graphiccardyo/project-lhy18krg47/analysis/pid_design/summary.txt

플랜트: K∈(0.12, 0.15, 0.21), T=0.328 s, L=16 ms, 공진 3.47 Hz ζ=0.123;  강인성 평가: K×ωr(±10%) 9개 조합

Z-N 한계 이득 (공칭 K=0.15 모델): Ku = 11.49 PWM/°, Tu = 0.299 s (3.35 Hz) — 위상 −180° 가 3.5 Hz 구조 공진에서 일어남
  (K=0.21 이면 Ku = 8.21 — 이득 변동만으로 한계가 29% 줄어듦)

설계                           Kp     Ki     Kd |   공칭Ms   최악Ms    GM     PM     안정 |    tr   OS%    ts    Δu  ess%
P (Ms≤2.0)                 3.70   0.00  0.000 |   1.47   2.00   6.0    nan      예 |  0.42   1.4  0.72    19  64.3
PI (Ti=T, Ms≤1.6)          2.76   8.40  0.000 |   1.32   1.60   8.5   86.6      예 |  1.63   0.3  2.29    34   0.2
PI + 노치 (Ms≤1.6)           7.85  23.93  0.000 |   1.31   1.60   8.7   65.1      예 |  0.40   0.5  0.61    46  -0.0
PID + 노치 (Td=0.05Ti)       7.89  24.05  0.129 |   1.25   1.60   8.6   69.4      예 |  0.42   0.9  0.62    45  -0.0
PID + 노치 (Td=0.10Ti)       7.24  22.07  0.237 |   1.21   1.60   8.6   74.7      예 |  0.50   1.2  0.70    42  -0.1
Z-N P                      5.74   0.00  0.000 |   2.00   4.47   2.2    nan      예 |  0.40   3.3  0.71    29  53.7
Z-N PI                     5.17  20.76  0.000 |   1.82   3.40   3.1   74.6      예 |  0.62   1.9  0.78    37  -0.0
Z-N PID                    6.89  46.13  0.258 |   4.36  28.82  -1.1  -18.9    아니오 |  0.30  15.1  1.13    53  -0.0
Z-N PID + 노치               6.89  46.13  0.258 |   1.37   1.56   8.9   47.0      예 |  0.26  22.7  1.04    59  -0.0

최악Ms·GM[dB]·PM[°]·안정 = 9개 플랜트 조합(K 0.12–0.21 × 공진 ±10%) 중 최악값. tr = 10–90% 상승시간[s], OS·ts(5%)는 최종값 기준, ess = 기준 대비 정상상태 오차[%].
최악Ms > 2 이거나 안정 = 아니오 이면 하드웨어 실험 전에 이득을 낮추세요. Δu = PWM 150 기준 최대 변화.
노치: fn=3.47 Hz, ζz=0.15, ζp=0.70 (출력단 2차 필터). D 항: 자이로 ω 10 Hz LPF, 측정값에 적용.
