graphiccardyo/project-lhy18krg47/data/20261106/analysis/REPORT.md

# 2026-11-06 실험 데이터 — 전달함수 추정 (별도 검증 데이터 없음)

재현: `python analysis/aero_analyze.py data/20261106` → 이 폴더의 `summary.txt`, `static_map.png`, `ringing.png`, `dynamic_fit.png`

| 파일 | 시험 | 조건 |
|---|---|---|
| aero_STAIR_…134531 | 정적 특성 | PWM 50→250 (10씩), 계단 3 s |
| aero_STAIR_…134817 | 정적 특성 | PWM 50→250 (10씩), 계단 1.5 s |
| aero_STEP_…135028 | 스텝 | PWM 180→192→180, pre 12 s / 10 s / 10 s |
| aero_CHIRP_…135133 | 스윕 사인 | PWM 180 ± 12, 0.1→3 Hz 로그, 60 s |

공통 설정: 축 Z−, Madgwick β = 0.301, DLPF 2 (94 Hz), Ts = 10 ms, 샘플 누락 없음.

## 결론

**이 데이터로는 신뢰할 수 있는 동적 전달함수를 얻을 수 없습니다.** 원인은 모델 차수나 추정 방법이 아니라 각도 측정입니다.

1. **가속도계가 프로펠러 진동에 묻혔습니다.** 모터가 돌면 θ<sub>acc</sub>가 ±150° 범위로 흔들립니다(σ 63–84°). β = 0.301로 가속도 비중이 높아 Madgwick θ가 실제 자세에서 벗어나 떠내려갑니다. 그 결과 자이로 적분각과 최대 11–92° 차이가 나고, 정적 특성 그래프가 단조롭지 않습니다.
2. **자이로도 일부 오염되었습니다.** ω에 약 37 Hz, σ 44–123 °/s의 진동이 실려 있습니다. 같은 조건의 정적 특성 두 번이 절대 각도에서 크게 다르게 나왔습니다(PWM 250에서 55° vs 112°). 두 번째 측정에서는 PWM 80일 때 1.5 s 동안 75°가 한쪽으로 쌓였습니다. 진동이 센서 내부 필터 이전 단계에서 ±500 °/s를 넘어 클리핑된 것(비대칭 → 가짜 직류 성분)으로 추정합니다.
3. **스텝·스윕(PWM 180 ± 12)의 신호 대 잡음비가 낮습니다.** 대역별 SNR은 0.5–5이고, 응답 진폭(약 2–4°)이 잡음과 비슷합니다. 2차 모델을 출력오차로 맞추면 적합도는 15% 미만이고, 실험 간 교차검증(STEP↔CHIRP)은 음수입니다.

## 잠정 모델 (검증되지 않음)

그나마 일관된 두 정보로 만든 모델입니다.

- **정적 기울기**(∫ω 기준, PWM 160–200): 0.202, 0.230 °/PWM → **K ≈ 0.22 °/PWM**. 두 번의 측정이 일치합니다. 절대 각도는 서로 달라도 기울기는 드리프트의 영향을 덜 받습니다.
- **자유 진동**(정적 특성 계단 직후 링잉, 감쇠 정현 맞춤): PWM 70→80에서 ωn = 3.65 rad/s, ζ = 0.11(적합 97%). PWM 120→130에서 ωn = 3.46, ζ = 0.30(76%). → **ωn ≈ 3.5 rad/s (0.56 Hz), ζ ≈ 0.1–0.3**.

```
G(s) ≈ K ωn² / (s² + 2ζωn s + ωn²) ≈ 2.7 / (s² + 1.4 s + 12.3)   [deg / PWM]   (K=0.22, ωn=3.5, ζ=0.2)
MATLAB:  G = tf(0.22*3.5^2, [1 2*0.2*3.5 3.5^2]);
```

이 모델도 스텝·스윕 데이터에 대해 적합도가 음수입니다. 따라서 **PID 설계의 출발점으로만** 쓰고, 측정을 고친 뒤 다시 추정해야 합니다. ζ의 불확실성이 특히 큽니다(0.1–0.47).

## 다시 실험하기 전에 고칠 것

**펌웨어에는 반영했습니다 (2026-11-06)**: ±16 g / ±2000 °/s, DLPF 4 기본, β 0.02 기본, 가속도 5 Hz 저역통과 + 게이팅, 포화·게이트 지표 표시. 기존 EEPROM의 축·자이로 보정·영점은 유지되고 β·DLPF만 새 기본값으로 바뀌었습니다. 남은 것은 아래 표의 기계적 조치와 실험 방법입니다.

| 항목 | 이번 | 권장 |
|---|---|---|
| 센서 장착 | — | 고무/폼으로 진동 절연, 프로펠러 균형 확인 |
| DLPF | 2 (94 Hz) | 5 (10 Hz) 또는 4 (21 Hz) — 진자 대역(<3 Hz)은 영향 거의 없음 |
| 센서 범위 | ±4 g / ±500 °/s | ±16 g / ±2000 °/s (센서 내부 클리핑 방지, 펌웨어 수정 필요) |
| Madgwick β | 0.301 | 0.01–0.03 (자이로 위주) |
| 가진 진폭 | ±12 PWM | ±25–40 PWM (SNR↑, 단 비선형 확인) |
| 반복 | 1회 | 같은 시험 2회 이상 (재현성 확인 = 검증 데이터 역할) |

측정을 고친 뒤 확인할 것: 모터를 켠 정지 상태에서 θ<sub>acc</sub>와 Madgwick θ가 몇 도 안에서 일치하는지, 그리고 같은 정적 특성 시험을 두 번 했을 때 결과가 겹치는지.

검증 데이터가 따로 없어도 MATLAB에서 `aero_sysid_all({스텝, 스윕, PRBS…}, 'angle', 'gyro')`로 합동 추정과 실험 간 교차검증을 할 수 있습니다.
