graphiccardyo/project-lhy18krg47/data/20261106_run2/analysis/REPORT.md

# 2026-11-06 2차 실험 데이터 평가 (펌웨어 진동 대책 후)

재현:
```
python analysis/aero_analyze.py data/20261106_run2      # 품질·재현성·정적 특성·교차검증 → summary.txt, *.png
python analysis/aero_freqresp.py data/20261106_run2      # CHIRP 주파수응답 → freqresp.png
```
그림: `raw.png`(원 데이터), `static_map.png`, `dynamic_fit.png`, `freqresp.png`, `model_check.png`(최종 모델 비교)

| 파일 | 시험 | 조건 |
|---|---|---|
| MANUAL_141518 | 수동 | PWM 0→250 수동 증가 (식별에는 사용 안 함) |
| STAIR_141550, STAIR_141657 | 정적 특성 ×2 | PWM 50→250, 10씩, 계단 3 s |
| STEP_141825, STEP_141904 | 스텝 ×2 | PWM 150→162→150, pre 12 s / 10 s / 10 s |
| CHIRP_141943, CHIRP_142059 | 스윕 사인 ×2 | PWM 150 ± 12, 0.1→3 Hz 로그, 60 s |

공통: 축 Z−, β = 0.02, DLPF 4, ±16 g / ±2000 °/s, Ts = 10 ms, 샘플 누락 없음.

## 1. 데이터 품질: 식별에 쓸 수 있음

| 지표 | 1차 실험 (β 0.301, DLPF 2) | 2차 실험 (이번) |
|---|---|---|
| θ<sub>acc</sub> 흔들림 σ | 63–84° | **22–27°** |
| 자이로 진동 σ | 44–123 °/s | **23–36 °/s** |
| Madgwick θ와 ∫ω 차이 (중앙값) | 수십 ° 떠내려감 | **0.8°** (최대 1.3–5°, 한 기록만 17°) |
| 반복 실험 상관 (스텝 / 스윕) | — | **0.945 / 0.874** |
| 정적 특성 반복 차이 | 55° vs 112° (불일치) | **RMS 1.0°, 최대 1.9°** |
| 단일 기록 SNR (반복 쌍으로 계산) | 0.5–5 | **6.4 (스텝), 7.4 (스윕)** |

진동이 여전히 있지만(θ<sub>acc</sub> ±25°), 게이팅과 작은 β 덕분에 Madgwick θ가 오염되지 않았습니다. 그래서 이번에는 **기록된 θ를 그대로** 분석에 썼습니다. 같은 시험을 두 번씩 한 덕분에, 별도 검증 데이터 없이도 잡음 수준과 재현성을 직접 확인할 수 있습니다.

**SNR이 6–7이면 어떤 모델이든 단일 기록 적합도의 상한이 약 63–66%입니다.** 아래 적합도는 이 상한과 비교해서 읽어야 합니다.

## 2. 정적 특성 (시험 1)

| PWM | 50 | 100 | 130 | 150 | 170 | 200 | 250 |
|---|---|---|---|---|---|---|---|
| θss (1회) | 4.9 | 11.4 | 17.1 | 21.9 | 24.6 | 29.3 | 39.7 |
| θss (2회) | 6.0 | 12.5 | 17.4 | 21.6 | 26.0 | 31.2 | 40.3 |

- 거의 직선에 가깝게 단조 증가합니다(PWM 50→250에서 5°→40°). 이번 범위에서는 뚜렷한 사각지대가 보이지 않습니다.
- **운전점 PWM 150 부근 국소 이득: 0.19–0.21 °/PWM** (PWM 130–170 회귀).
- 모터를 켜기 전 시작 각도가 기록마다 **+2.4~+5.0°**입니다. 펌웨어를 바꾼 뒤 영점을 다시 잡지 않은 것과, 피벗 마찰로 정지 위치가 매번 조금 달라지는 것이 겹친 것으로 보입니다. 절대 각도에는 수 도의 오프셋이 있고, 기울기(이득)에는 영향이 거의 없습니다.

## 3. 동적 응답 (시험 2)

- **스텝**: +12 PWM에 약 1 s 안에 **오버슈트 없이** Δθ ≈ 2.1–2.6°로 올라갑니다(과감쇠). 정상상태 이득은 0.17–0.21 °/PWM입니다.
- **주파수응답**(스윕 사인 2회, 기록 간 차이 대부분 3–15%):

| f [Hz] | 0.10 | 0.20 | 0.38 | 0.60 | 0.94 | 1.47 | 2.29 | 2.86 |
|---|---|---|---|---|---|---|---|---|
| \|G\| [°/PWM] | 0.165 | 0.145 | 0.119 | 0.101 | 0.076 | 0.060 | 0.065 | 0.084 |
| 위상 [°] | −23 | −32 | −38 | −54 | −69 | −90 | −111 | −142 |

  0.1–1.5 Hz에서는 1차 지연과 비슷한 모양이고, **진자형 공진 봉우리는 없습니다**(이 운전점에서는 진자가 강하게 감쇠됨). 2 Hz 위에서는 이득이 다시 오르고 위상이 빨리 떨어집니다. **약 3 Hz 이상에 다른 모드**(막대·구조 진동 등)가 있을 수 있습니다.
- 정적 특성 계단 직후의 "링잉" 맞춤(ζ≈0.4–0.55, ωn≈2.2–2.7)은 스텝·주파수응답과 맞지 않습니다(주파수응답 오차 85–107%). 계단 직후의 진동 잡음을 감쇠 정현으로 잘못 맞춘 것이므로 쓰지 않습니다.

## 4. 전달함수 추정 (시험 3, 별도 검증 데이터 없이)

스텝 2개와 스윕 2개 모두를 대상으로, **기록 하나를 빼고 추정한 뒤 뺀 기록에 비교하는 교차검증**을 했습니다.

| 모델 구조 | 교차검증 적합도 (CHIRP₁, CHIRP₂, STEP₁, STEP₂) | 평균 |
|---|---|---|
| 1차 + 지연 | 44, 43, 65, 32 % | **46.1 %** |
| 2차 (실극점 2개) + 지연 | 43, 43, 66, 32 % | 46.1 % (두 번째 극점이 사라져 1차와 같음) |
| 2차 (복소극점 허용) + 지연 | 43, 43, 66, 32 % | 46.1 % (ζ→4, 과감쇠로 수렴) |
| 영점 + 극점 2개 + 지연 | 42, 43, 66, 35 % | 46.6 % (느린 성분 τ≈6 s, 개선 미미) |

차수를 올려도 교차검증이 좋아지지 않으므로 **1차 + 지연**을 채택합니다. 느린 성분(τ≈6 s)은 두 번의 스텝에서 크리프 방향이 반대로 나왔습니다(θ: 0.00° / +0.29°, ∫ω: −0.75° / +0.53°). 따라서 물리적인 응답이 아니라 **±0.5–1°의 저주파 드리프트**로 판단합니다. 잡음 상한(63–66%)과 실제 적합도(46%) 사이의 차이는 대부분 이 드리프트 때문입니다(STEP₂는 하강 후 +0.8°에 머묾).

### 추정 모델 (운전점 PWM ≈ 150, θ ≈ 22°)

```
G(s) = Δθ(s)/ΔPWM(s) = 0.174 · e^(−0.025 s) / (0.341 s + 1)     [deg / PWM]
     = 0.510 · e^(−0.025 s) / (s + 2.93)
MATLAB:  G = tf(0.174, [0.341 1], 'InputDelay', 0.025);
```

| 파라미터 | 값 | 불확실성 / 근거 |
|---|---|---|
| 정상상태 이득 K | 0.174 °/PWM | **0.17–0.21** (스윕 저주파 0.16, 스텝 0.17–0.21, 정적 기울기 0.19–0.21) |
| 시정수 T | 0.34 s (극점 −2.9 rad/s, 0.47 Hz) | 교차검증 모델 간 0.34–0.35 s |
| 지연 L | 25 ms | 20–50 ms |
| 유효 대역 | 0.1–1.5 Hz | 2 Hz 이상 미모델 동특성 가능 |

## 5. 평가 요약

- **사용 가능**: 진동 대책 후 데이터는 재현성이 좋고(상관 0.87–0.95), 정적 특성·스텝·주파수응답이 서로 일관됩니다(이득 0.17–0.21 °/PWM).
- **모델 신뢰도는 보통**: 교차검증 적합도 46%(잡음 상한 약 65%). PID 설계에는 충분하지만, 이득을 ±10–15% 불확실한 것으로 보고 강인하게 설계하세요(예: K = 0.17과 0.21 둘 다로 폐루프 검토).
- **이 운전점(PWM 150)에서만 유효한 소신호 모델**입니다. 정적 특성 기울기가 PWM 160–200에서는 0.15–0.18로 조금 작아지므로, 다른 각도에서 제어하려면 그 운전점에서 다시 식별하세요.

## 6. 다음 실험에서 개선할 것

1. **영점 다시 잡기**: 시작 각도가 +2.4~5°입니다. 실험 직전에 "정지 보정 + 영점"을 하세요.
2. **가진 진폭 키우기**: ±12 → ±25 PWM으로 키우면 SNR이 약 4배가 됩니다(선형 범위는 정적 특성상 PWM 125–175 정도에서 무난함).
3. **드리프트 줄이기**: 시험 시간을 줄이거나(스윕 30–40 s) 반복 횟수를 늘려 평균하세요. 정지 상태 θ가 몇 분 동안 얼마나 떠내려가는지도 한 번 기록해 두면 좋습니다.
4. **2 Hz 이상 확인**: 폐루프 대역을 1 Hz 넘게 잡을 계획이면 0.5–5 Hz 스윕을 따로 해서 3 Hz 부근 모드를 확인하세요.
5. 센서 진동 절연은 여전히 권장합니다(θ<sub>acc</sub> ±25°, 자이로 진동 약 46 Hz).
