graphiccardyo/project-lhy18krg47/data/20261106_run3/analysis/REPORT.md

# 2026-11-06 최근 두 run 평가 (고주파 확인 · 진폭 확대)

| run | 파일 | 조건 | 목적 |
|---|---|---|---|
| **A** | CHIRP_143402, CHIRP_143517 | PWM 150 ± 12, **0.1→10 Hz** 로그, 60 s | 2 Hz 이상 동특성 확인 |
| **B** | CHIRP_143817, CHIRP_143940 | PWM 150 ± **25**, 0.1→7 Hz 로그, 60 s | 진폭 확대(SNR↑) |

공통: 축 Z−, β 0.02, DLPF 4, ±16 g / ±2000 °/s, 샘플 누락 없음, 각 조건 2회 반복.

재현:
```
python analysis/aero_analyze.py data/20261106_run3
python analysis/aero_model_fit.py --est data/20261106_run3/aero_CHIRP_20261106_143817.csv data/20261106_run3/aero_CHIRP_20261106_143940.csv --val "data/20261106_run3/aero_CHIRP_*.csv" "data/20261106_run2/aero_CHIRP_*.csv" "data/20261106_run2/aero_STEP_*.csv"
```
그림: `raw.png`, `model_fit.png`(주파수응답 + 모든 기록 시간영역 비교)

## 1. 품질

| 지표 | run2 (±12, 0.1–3 Hz) | **run A** (±12, 0.1–10 Hz) | **run B** (±25, 0.1–7 Hz) |
|---|---|---|---|
| θ<sub>acc</sub> σ / 자이로 진동 σ | 25–27° / 35 °/s | 20–22° / 27–29 °/s | 17–19° / 25–27 °/s |
| Madgwick θ vs ∫ω (최대 차) | 2.5–5° | 1.8° | 1.5–5.9° |
| 반복 쌍 상관 | 0.874 | 0.808 | **0.976** |
| 단일 기록 SNR | 7.4 | 4.6 | **25** |
| 잡음 한계 적합도 | ≈66% | ≈58% | **≈80%** |

- **run B가 지금까지 데이터 중 가장 좋습니다.** 진폭을 두 배로 하자 SNR이 3–4배가 됐습니다.
- run A의 SNR이 낮은 것은 정상입니다. 같은 60 s를 10 Hz까지 나눠 쓰다 보니 응답이 거의 없는 고주파(>5 Hz, 응답 ≈0.05°)에 시간을 많이 썼기 때문입니다. 6 Hz 이상의 값은 잡음 수준이라 쓰지 않습니다.
- **오프셋 점프**: CHIRP_143402는 가진이 시작되자 진동 중심이 약 +1.5° 올라가 유지됐습니다. CHIRP_143517은 공진 통과(약 60 s) 직후 약 −1° 내려갔습니다. 진폭이 커지는 순간 피벗 정지마찰이 풀리면서 정지 위치가 바뀌는 것으로 보입니다. 동특성 분석에서는 가진 구간 평균을 빼서 처리했습니다(이 처리 전에는 143402의 적합도가 −94%로 나왔음).

## 2. 새로 확인한 것: 3.5 Hz 기계 공진

주파수응답(두 run 모두, 반복 차이 대부분 2–15%):

| f [Hz] | 0.3 | 0.9 | 1.6 | 2.35 | 2.83 | **3.41** | 4.11 | 4.95 | 5.96 |
|---|---|---|---|---|---|---|---|---|---|
| \|G\| run A | 0.116 | 0.068 | 0.048 | 0.047 | 0.058 | **0.074** | 0.038 | 0.013 | 0.006 |
| \|G\| run B | 0.113 | 0.068 | 0.048 | 0.046 | 0.056 | **0.066** | 0.033 | 0.012 | 0.005 |
| 위상 run B | −32° | −69° | −91° | −107° | −127° | **−187°** | −253° | −277° | −287° |

- **약 3.47 Hz에서 이득이 다시 올라가고(1차 모델 대비 약 3배), 위상이 180° 급격히 떨어집니다.** 약하게 감쇠된(ζ≈0.12) 2차 모드입니다. 진자 자체의 흔들림(1 Hz 미만)이 아니라 막대·모터 마운트의 굽힘 같은 구조 모드로 보입니다.
- 지난 보고서에서 "2 Hz 이상에서 이득이 오름 — 3 Hz 부근 모드 가능"이라고 했던 부분이 이번에 확인되었습니다.
- **선형성**: ±12와 ±25의 이득이 0.3–6 Hz에서 5% 안에서 일치합니다. 진폭을 두 배로 해도 응답 모양이 같으므로 운전점 주변의 선형 모델이 타당합니다.

## 3. 전달함수

run B(±25) 주파수응답에 맞추고, 나머지 모든 기록에 시뮬레이션해 검증했습니다(별도 검증 데이터 없이 실험 간 교차검증).

```
G(s) = K · e^(−0.016 s) / (0.328 s + 1) · 21.8² / (s² + 5.37 s + 21.8²)      [deg/PWM]
       공진 fr = 3.47 Hz (ωr = 21.8 rad/s), ζr = 0.12,  시정수 T = 0.33 s,  지연 16 ms (DLPF 21 Hz 지연 약 8 ms 포함)
MATLAB:  G = tf(K*21.8^2, conv([0.328 1], [1 5.37 21.8^2]), 'InputDelay', 0.016);
```

| 검증 기록 | 형태와 K 모두 run B 값 (K=0.131) | 형태 고정, K만 기록별로 맞춤 | 잡음 한계 |
|---|---|---|---|
| run B CHIRP ×2 (추정에 사용) | 79%, 78% | 81%, 80% (K 0.144 / 0.121) | ≈80% |
| run A CHIRP ×2 | 65%, 55% | 65%, 55% (K 0.127 / 0.134) | ≈58% |
| run2 CHIRP ×2 (15분 전) | 56%, 64% | 59%, 68% (K 0.155 / 0.159) | ≈66% |
| run2 STEP ×2 (20분 전) | 46%, 17% | 77%, 36% (K 0.205 / 0.188) | ≈63% |

- **형태(T, 지연, 공진)는 모든 실험에서 일관됩니다.** K만 맞추면 모든 기록이 각자의 잡음 한계 근처까지 맞습니다. 이 형태를 확정 모델로 봐도 됩니다.
- 주파수응답 오차 9%, 0.12–7 Hz에서 크기·위상 모두 일치(`model_fit.png` 위쪽).
- 0.12 Hz 미만에서는 Madgwick θ와 자이로 적분각의 위상이 다르게 나옵니다(−21° vs −1°). Madgwick의 느린 가속도 보정이나 드리프트에 의한 측정 쪽 효과로 보고 모델에 넣지 않았습니다.

## 4. 문제: 이득 K가 시간에 따라 줄어듦

| 시각 | 기록 | K [°/PWM] | PWM 150 정착 각도 |
|---|---|---|---|
| 14:16–14:18 | run2 STAIR | (정적 기울기 0.19–0.21) | 21.6–21.9° |
| 14:18–14:19 | run2 STEP | 0.19–0.21 | 22.3–23.4° |
| 14:19–14:22 | run2 CHIRP | 0.155–0.159 | 23.5–23.9° |
| 14:34–14:35 | run A | 0.127–0.134 | 20.0–20.9° |
| 14:38–14:39 | run B | 0.121–0.144 | 19.0–19.1° |

- 20분 사이에 같은 PWM 150에서 **정착 각도가 약 3°, 이득이 약 20% 줄었습니다.** 추력이 약해졌다는 뜻입니다. **모터 전원 전압 강하**(배터리 소모, 전원장치 전류 제한)나 **모터 발열**을 의심합니다. 입력을 PWM으로 쓰므로 전원 전압이 바뀌면 플랜트 이득이 그대로 바뀝니다.
- 같은 시각대에서도 스텝(0.19–0.21)이 스윕(0.155)보다 큽니다. 한 방향으로 올리는 입력(스텝·계단)과 양방향으로 흔드는 입력(스윕)의 차이로 보이며, 피벗 마찰 같은 작은 비선형이 원인일 수 있습니다.

## 5. PID 설계에 주는 의미

- **K 범위 0.12–0.21 °/PWM** (공칭 약 0.15). 안정성은 큰 쪽(0.21), 성능은 작은 쪽(0.12)으로 검토하세요.
- **위상 −180° 교차 3.38 Hz, 그때 |G| ≈ 0.076 °/PWM** (K=0.131 기준). 순수 P 제어라면 이득 한계가 약 13 PWM/°이고, K=0.21이면 약 8 PWM/°입니다.
- 3.5 Hz 공진 때문에 **폐루프 교차주파수는 약 1 Hz 이하**로 잡으세요. D 항은 공진을 증폭하므로 미분 필터(예: 10–15 Hz 1차)를 쓰고, 필요하면 3.5 Hz 노치 필터를 고려하세요.
- Z-N 방법(목표 6): 이 플랜트는 순수 P로 진동 한계에 도달하는 주파수가 약 3.4 Hz, 즉 구조 공진입니다. Ku/Tu가 진자 동특성이 아닌 공진으로 정해지므로, Z-N 결과는 공격적으로 나올 수 있습니다. 실험할 때 주의하세요.

## 6. 다음 실험 권장

1. **모터 전원 전압을 기록**하세요. 실험 전후, 가능하면 부하 상태에서 측정합니다. 배터리라면 안정화된 전원장치를 쓰거나 매 실험 전 전압을 맞추세요. 펌웨어에 전압 측정(분압기 → A0)을 추가하면 기록에 함께 남길 수 있습니다.
2. 스텝·스윕을 **연달아** 같은 조건에서 하면 이득 차이(스텝 vs 스윕)와 시간 변화를 분리할 수 있습니다.
3. 가진은 run B 조건(±25, 0.1–7 Hz)이 가장 좋습니다. 저주파 이득을 더 정확히 하려면 0.05 Hz부터 시작하거나 지속 시간을 늘리세요.
4. 실험 직전 영점을 다시 잡으세요. 시작 각도가 −0.0°~+4.1°로 여전히 기록마다 다릅니다.
