graphiccardyo/project-lhy18krg47/analysis/pid_design/loop_shapes.png

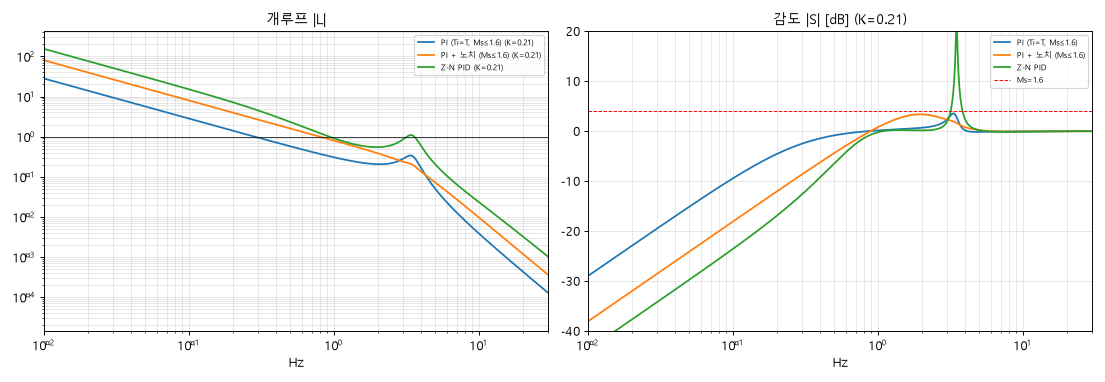
analysis/pid_design/loop_shapes.png
