graphiccardyo/project-lhy18krg47/data/20261106/analysis/dynamic_fit.png

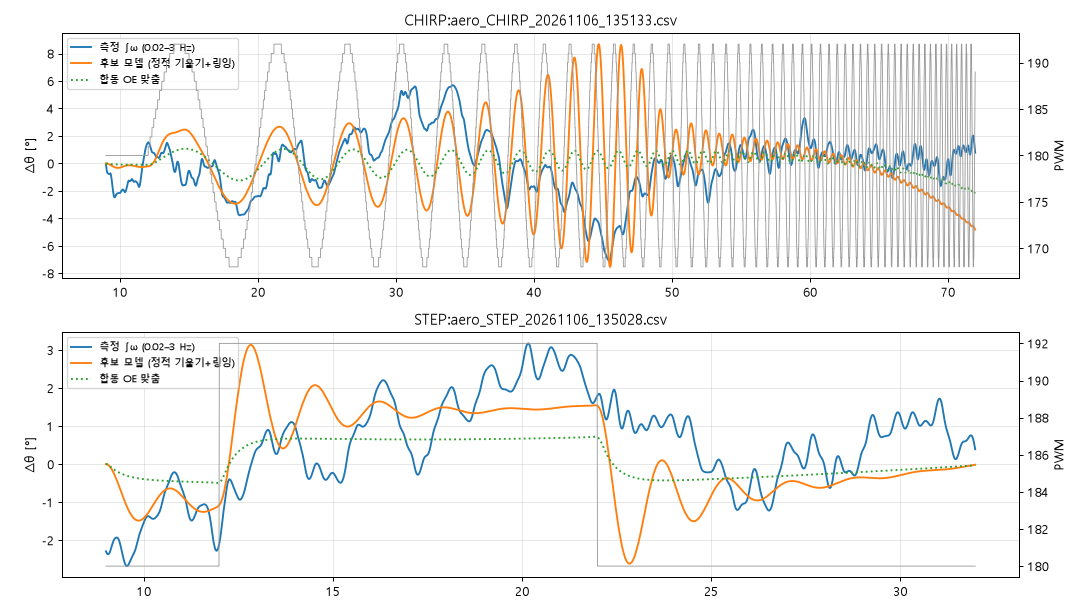
data/20261106/analysis/dynamic_fit.png
