graphiccardyo/project-lhy18krg47/data/20261106/analysis/ringing.png

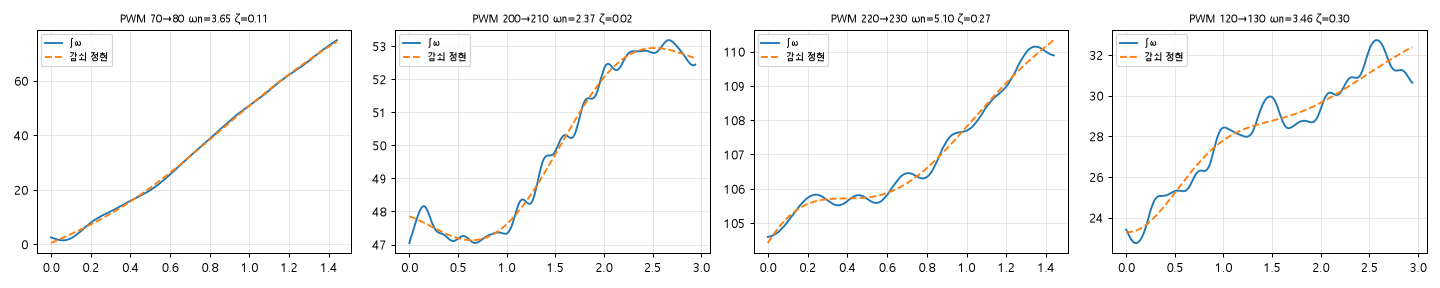
data/20261106/analysis/ringing.png
