graphiccardyo/project-lhy18krg47/data/20261106/analysis/static_map.png

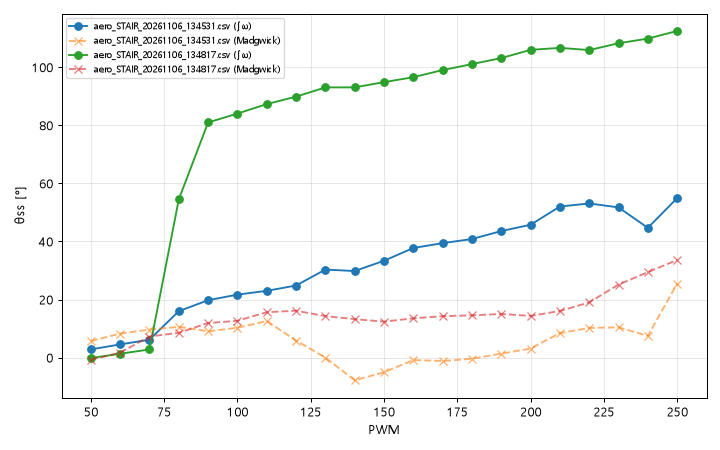
data/20261106/analysis/static_map.png
