graphiccardyo/project-lhy18krg47/data/20261106_run2/analysis/dynamic_fit.png

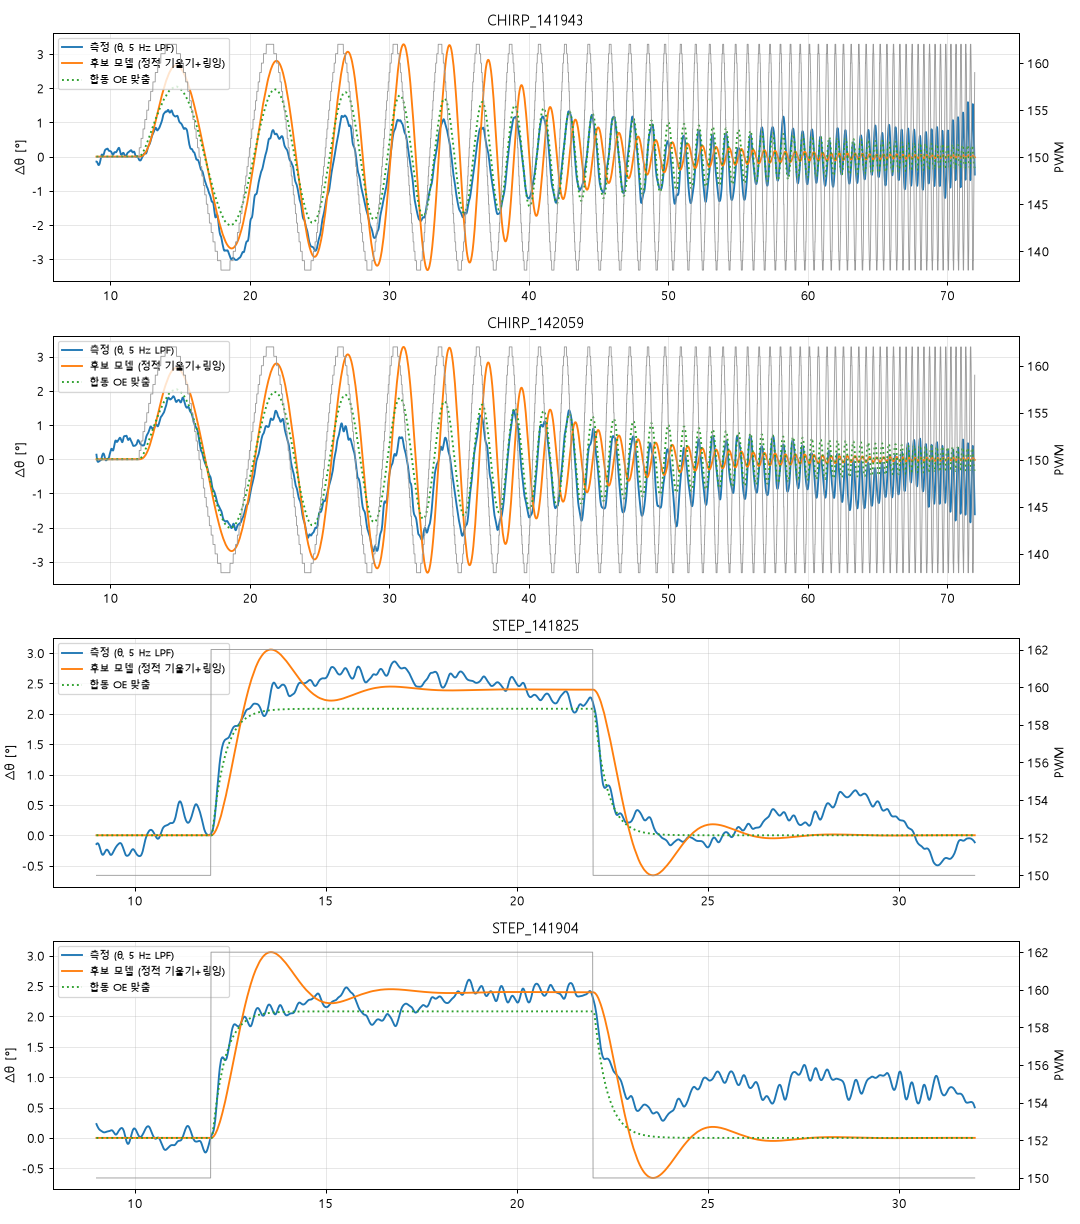
data/20261106_run2/analysis/dynamic_fit.png
