graphiccardyo/project-lhy18krg47/data/20261106_run2/analysis/model_check.png

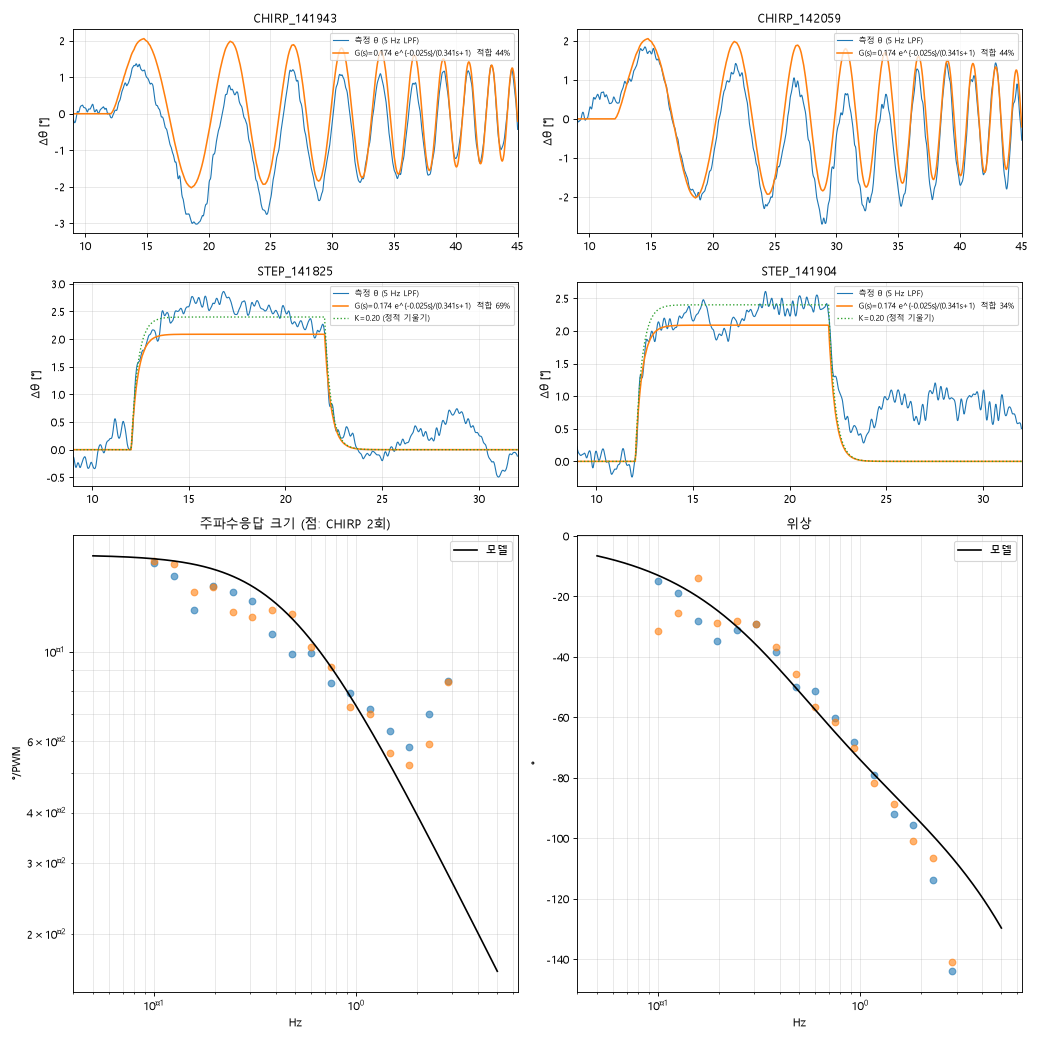
data/20261106_run2/analysis/model_check.png
