graphiccardyo/project-lhy18krg47/data/20261106_run3/analysis/model_fit.png

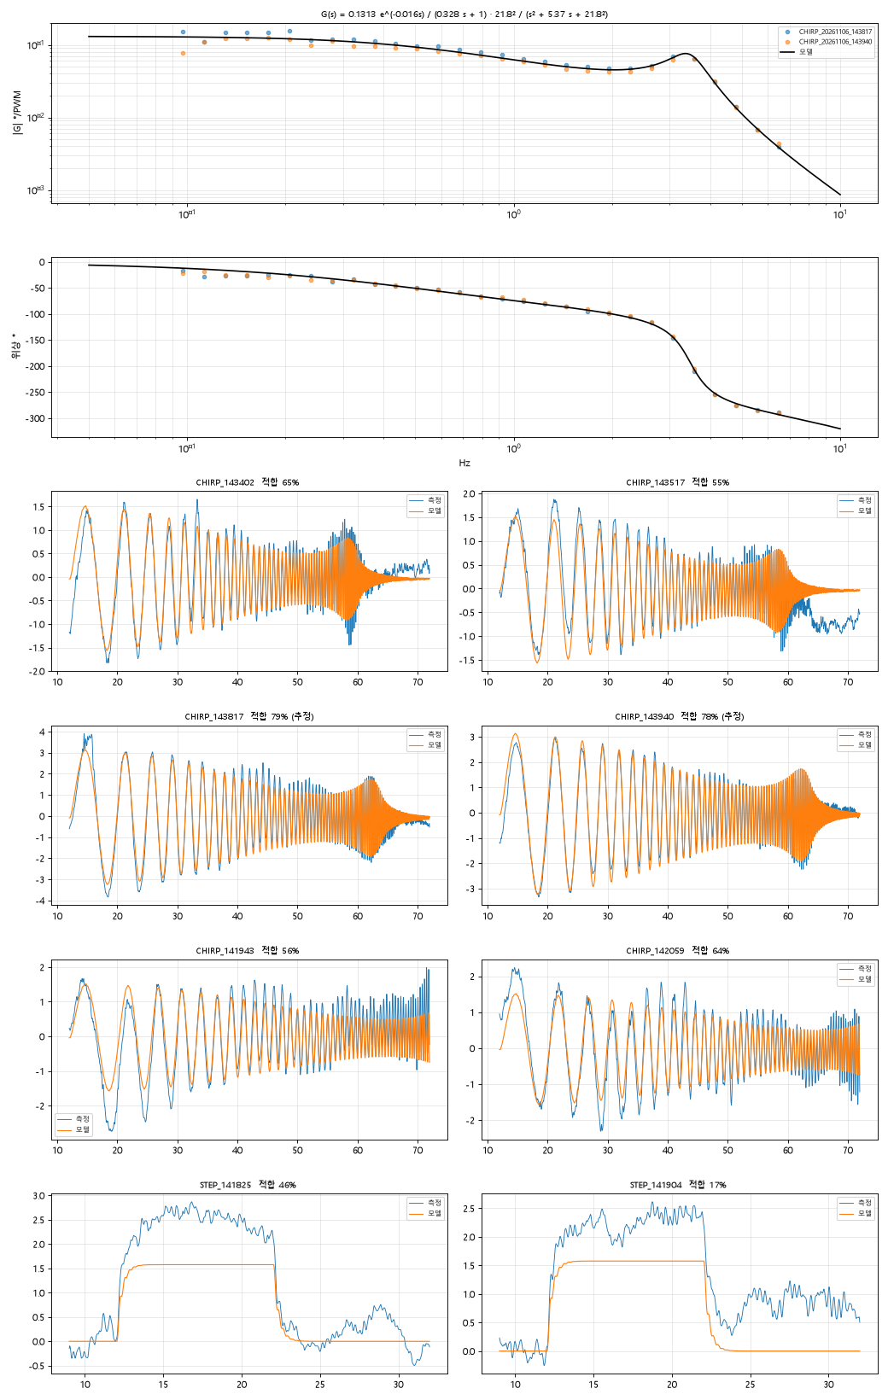
data/20261106_run3/analysis/model_fit.png
