graphiccardyo/project-lhy18krg47/data/20261106_run3/analysis/raw.png

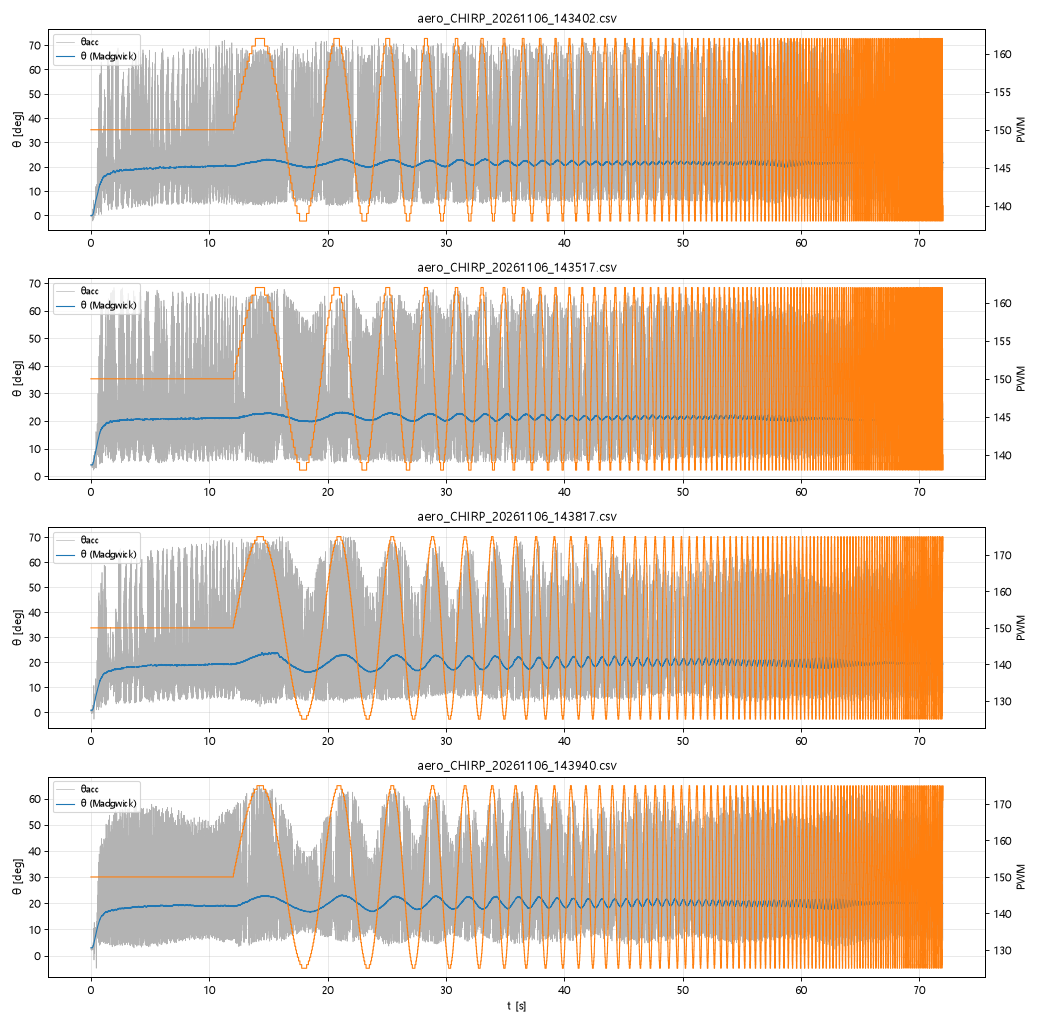
data/20261106_run3/analysis/raw.png
