graphiccardyo/project-lhy18krg47/data/20261106_run3/analysis/static_map.png

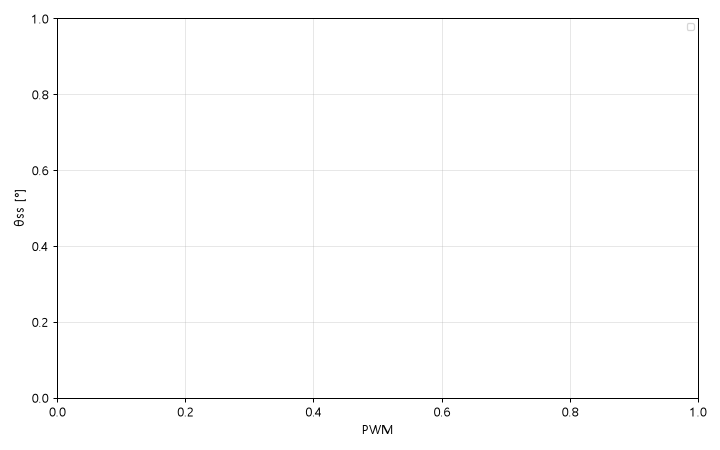
data/20261106_run3/analysis/static_map.png
