graphiccardyo/project-lhy18krg47/analysis/pid_design/step_responses.png

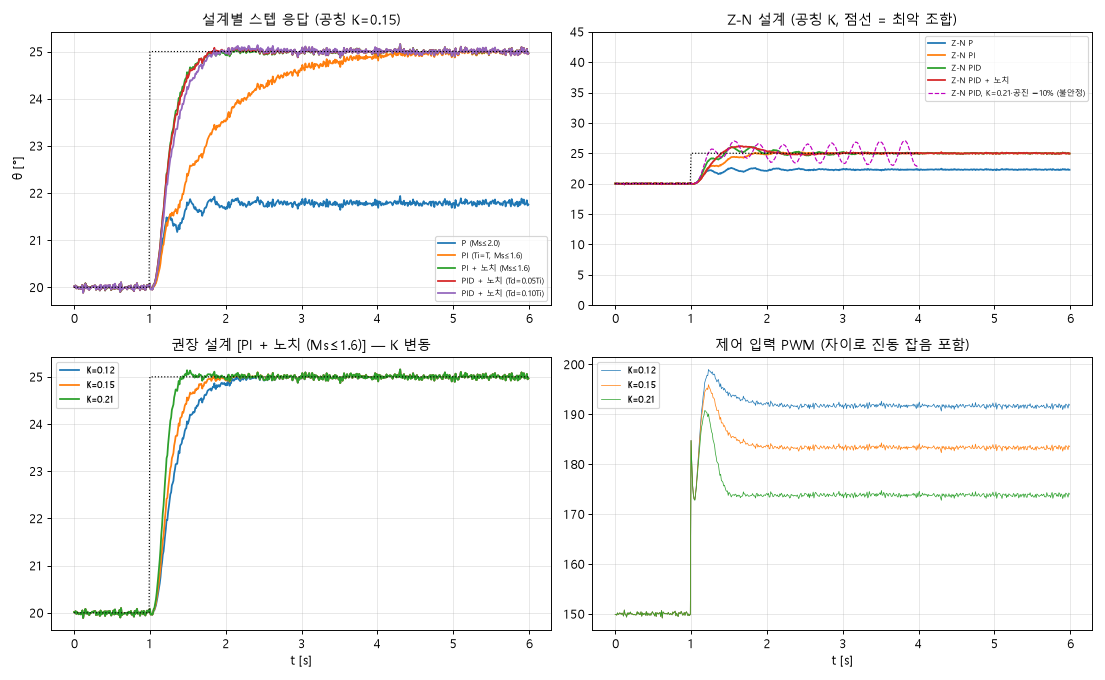
analysis/pid_design/step_responses.png
