graphiccardyo/project-lhy18krg47/(commit log)

2026-11-05 Aeropendulum 1주차: 모터·IMU 제어와 웹 시연
    Uno + L298N 모터 제어, MPU6050 자세 추정, 두 기능을 합친 웹 시연
    페이지와 펌웨어, PWM 없는 On/Off 제어, 검사 스크립트, 1주차 발표자료.
2026-11-06 최종 과제 중심으로 저장소 정리: 시스템 식별 · PID 실험 도구와 문서
    1주차 기구 확인용 프로그램(모터 단독 조절기, On/Off, MPU6050 모니터·비교,
    웹 데모, 핀 진단, 백업 hex 등)을 삭제하고 과제 목표 1–6 중심으로 재구성.
    - firmware/aeropendulum_lab: MPU6050 + Madgwick(진동 대책), 정지/수평 보정,
    STEP/STAIR/CHIRP/PRBS 가진, PID + 노치 폐루프, CLSTEP, 릴레이(Z-N), 안전장치
    - lab/: Web Serial 실험 UI(탭 ①–⑥), 식별 모델 기반 시뮬레이터, 계산 모듈
    - analysis/, matlab/: 데이터 진단, 주파수응답, 공진 포함 모델 맞춤, PID 설계
    - data/: 2026-11-06 실험 3회분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
    [aero_CHIRP_20261106_135133.csv, aero_CHIRP_20261106_141943.csv, aero_CHIRP_20261106_142059.csv, aero_CHIRP_20261106_143402.csv, aero_CHIRP_20261106_143517.csv, aero_CHIRP_20261106_143817.csv, aero_CHIRP_20261106_143940.csv, aero_MANUAL_20261106_141518.csv]
2026-11-13 UI: 안전 한계·샘플링을 바꾸는 즉시 보드에 적용
    수동 구동 탭에서 최대 PWM 등을 바꿔도 [적용] 버튼을 누르기 전에는 보드에
    전달되지 않아, 슬라이더 최대값과 시험 범위(보드 CFG 값 기준)가 그대로였음.
    - 최대 PWM / 각도 한계 / 역추력 변경 시 LIM, 샘플링 변경 시 STREAM 자동 전송
    - 입력값과 보드 설정이 다르면 경고 표시
    - 버튼은 '다시 적용'으로 유지
2026-11-13 펌웨어 2.1: 폐루프 기능 버전 구분, 오래된 펌웨어 경고, 보드 시험 수정
    PID 적용 시 ERROR: 보드에 폐루프 이전 펌웨어(2.0)가 남아 PID/REF/CLSTEP/RELAY 명령을
    몰랐음. 두 버전이 같은 버전 문자열을 써서 구분도 안 됐음.
    - 펌웨어 FW_ID 2.1 (폐루프 포함). 시뮬레이터도 2.1
    - UI: 연결 시 2.0 이면 업로드 안내, UNKNOWN_COMMAND/PROFILE 에 펌웨어 원인 표시
    - 이득 범위(Kp≤200, Ki≤500, Kd≤50)·노치 범위를 UI·시뮬레이터·펌웨어에서 동일하게
    - STOP/DONE 직후 시험 버튼 바로 활성화
    - Build-Lab.ps1: Arduino IDE 2 내장 arduino-cli 자동 탐색
    - Test-LabFirmware.ps1: 폐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
    [aeropendulum_lab.ino, app.js]
2026-11-13 폐루프 최소 PWM: 저속 모터 정지·재기동 지연 방지
    일정 PWM 아래에서 모터가 멈추고, 다시 추력이 필요할 때 재기동 지연이 커서
    폐루프 응답이 늦어지던 문제.
    - 펌웨어: PID kp ki kd ff [umin] (5번째 인자 선택, 생략 시 이전 값 유지)
    출력 범위 [umin, umax], 하한에서도 적분 정지, 릴레이 아래쪽도 umin 이상
    PIDCFG 에 umin= 추가 (플래시 97%, +138 B)
    - UI ⑥: '최소 PWM' 입력, 모델 예측·폐루프 비교 그래프에 반영, CSV # pid 줄에 umin
    - 시뮬레이터: 같은 하한 + 모터 정지(PWM<30)·재기동(≥45, 0.15 s) 모델
    - 보드 시험 4항목 추가 → 67/67 통과 (벤치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
2026-11-14 UI: 설정 저장·불러오기, 내장 PID 프리셋 제거
    - ⑥ 탭에 이름 붙인 설정 묶음 저장/불러오기/삭제 (이득·ff·최소 PWM·노치,
    모든 탭의 시험 설정, 안전 한계·샘플링). 브라우저 localStorage에 저장하고
    JSON 파일로 내보내기/가져오기 (팀원 공유용)
    - 불러오면 한계·샘플링이 바뀐 경우 보드에 바로 적용, 이득은 [이득 적용]으로
    - 연결 시 입력란의 이득을 보드에 자동 재전송 (보드는 전원을 켜면 이득 0)
    - 계산값 PID 프리셋 6종 제거, 이득 기본값 0·노치 끔
    - 문서: 실험 가이드, README, PID 설계 리포트 갱신. AGENTS.md에 RL용 플래시 측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
